purdue-fpga/hammerIO/README.md

### Deploy to GH Pages
```
sudo apt install mkdocs-material 
pip install ghp-import \ mkdocs-material-extensions \ pymdown-extensions
make
```

### Run locally in Docker
```
docker compose up
```
