purdue-fpga/hammerIO/docs/about.md

# About

This board was built as an SOET Capstone project by Team 27 during the 2024-2025 academic year.
