purdue-fpga/hammerIO/docs/info.md

# Known Issues and Recommendations

## Power Supply and Current Draw

The total current draw for the DE10-Lite board and the extension shield with all peripherals active at once is estimated at 491.3 mA. This value at peak usage approaches the limit of the voltage regulator's capacity of 500mA. While it is unlikely that users will operate all peripherals simultaneously, given the shield’s primary use in educational settings, users should still exercise caution when using additional expansions, like PMOD. Individual current draw values for each component are summarized below.

| Peripheral | Part Number | Current Draw while Active (mA) | Number of Components | Total Current Draw (mA) | Justification  |
|---|---|---|---|---|---|
| LEDs | 150141AS73100 | 20 | 8 | 160 | Datasheet |
| ADC | MAX11664 | 1.67 | 1 | 1.67 | Datasheet |
| DAC | AD7303 | 2.3 | 1 | 0.75 | Datasheet |
| Audio Codec (General) | SSM2603 | 19.6 | 1 | 19.6 | Datasheet |
| Audio Codec (Headphone Amplifier) | SSM2603 | 62.5 | 1 | 62.5 | Datasheet |
| Switch Pullup Resistors | N/A (10kΩ) | 0.33 | 8 | 2.64 | Ohm’s Law |
| LEDs (DE-10 Lite) | Unknown (330Ω current-limiting resistors) | 3.94 | 10 | 39.4 | Schematic |
| Switch Pullup Resistors (DE-10 Lite) | N/A (120kΩ) | 0.027 | 10 | 0.27 | Schematic |
| VGA Resistor Network (DE10-Lite) | N/A (Resistance varies) | 22.28 | 1 | 22.28 | Schematic |
| SDRAM (DE10-Lite) | IS42S16320D | 180 | 1 | 180 | Datasheet |
| Accelerometer (DE10-Lite) | ADXL345 | 0.14 | 1 | 0.14 | Datasheet |
| FPGA (DE10-Lite) | 10M50DAF484 | 0.60 | 1 | 0.60 | Datasheet |

## Clock Source Configuration

During testing, it was observed that using multiple clock sources to drive peripherals resulted in unexpected behavior in the Quartus software, including irregular placement of logic gates. To mitigate this issue, users should configure the FPGA to use a single clock source with appropriate clock dividers for different devices. This approach ensures stable and reliable operation of the shield.

## Signal Observation via Test Points

The board features multiple test points for signals, including the audio codec signals, I2C and SPI interfaces pins, and intermediate signals from PS/2, DAC and ADC. Users should exercise caution when probing these test points, as improper handling could lead to short circuit, noise interference or signal distortion.

## Jumper Configuration

Incorrect jumper settings for the ADC channels could result in unexpected input values. Users are encouraged to refer to the jumper configuration instructions and double-check their settings to ensure proper operation.

## Recommendations for Assembly

During installation, ensure that standoffs are securely tightened to avoid mechanical instability, which could damage the board or affect signal quality.

## Parts List

| Peripheral | Part # | Quantity |
|---|---|---|
| ADC | [MAX11664](https://www.digikey.com/en/products/detail/analog-devices-inc-maxim-integrated/MAX11664AUB-T/2776904) | 1 |
| DAC | [AD7303](https://www.digikey.com/en/products/detail/analog-devices-inc/AD7303BRMZ-REEL7/760443) | 1 |
| Audio Codec | [SSM2603](https://www.digikey.com/en/products/detail/analog-devices-inc/SSM2603CPZ-REEL7/1825572) | 1 |
| Voltage Regulator | [TLV1117LV33](https://www.digikey.com/en/products/detail/texas-instruments/TLV1117LV33DCYR/2666508) | 1 |
| PS/2 | [KMDTX-HT-6S-BSC](https://www.digikey.com/en/products/detail/kycon-inc/KMDTX-HT-6S-BSC/10246538) | 1 |
| SMA | [PCB.SMAFRA.HT](https://www.digikey.com/en/products/detail/taoglas-limited/PCB.SMAFRA.HT/5034736) | 5 |
| Audio Jack | [SJ-3524-SMT-TR](https://www.digikey.com/en/products/detail/same-sky-formerly-cui-devices/SJ-3524-SMT-TR-BE/2295987) | 3 |
| LED | [150141AS73100](https://www.digikey.com/en/products/detail/w%C3%BCrth-elektronik/150141AS73100/4489951) | 8 |
| SPDT Switch | [OS102011MS2QN1](https://www.digikey.com/en/products/detail/analog-devices-inc/SSM2603CPZ-REEL7/1825572) | 8 |
| Joystick | [Adafruit 2765](https://www.digikey.com/en/products/detail/adafruit-industries-llc/2765/6193582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) | 1 |
| 40 Pin Header | [474-PRT-16763](https://www.mouser.com/ProductDetail/SparkFun/PRT-16763?qs=W/MpXkg%252BdQ5xeCq/GKjnlQ%3D%3D&mgh=1&gQT=1) | 1 |
| Arduino Header | [uxcell 16mm-len](https://www.amazon.com/uxcell-Straight-Connector-Arduino-Prototype/dp/B07DK2FXZ9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) | 1 |
| Standoff | [93505A103](https://www.mcmaster.com/93505A103) | 4 |

All other components were purchased directly through the JLCPCB assembly service.
