purdue-fpga/hammerIO/extra-documentation/kicad-project/Peripheral Board V0.3.kicad_pcb

## KiCad design extra-documentation/kicad-project/Peripheral Board V0.3.kicad_pcb (2025-04-29)

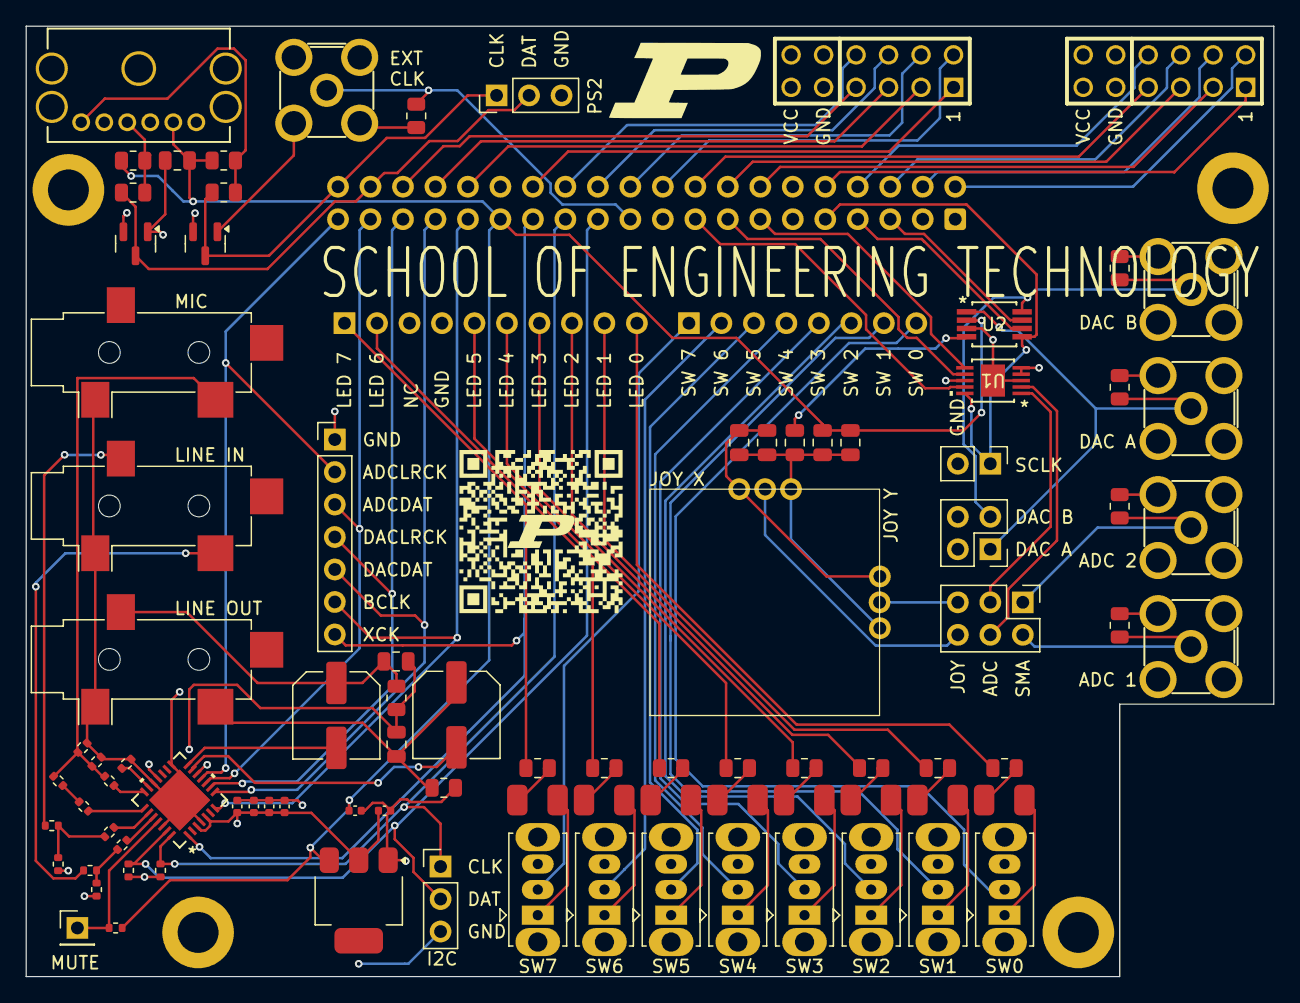
[picture p21: board Peripheral Board V0.3.kicad_pcb from above]

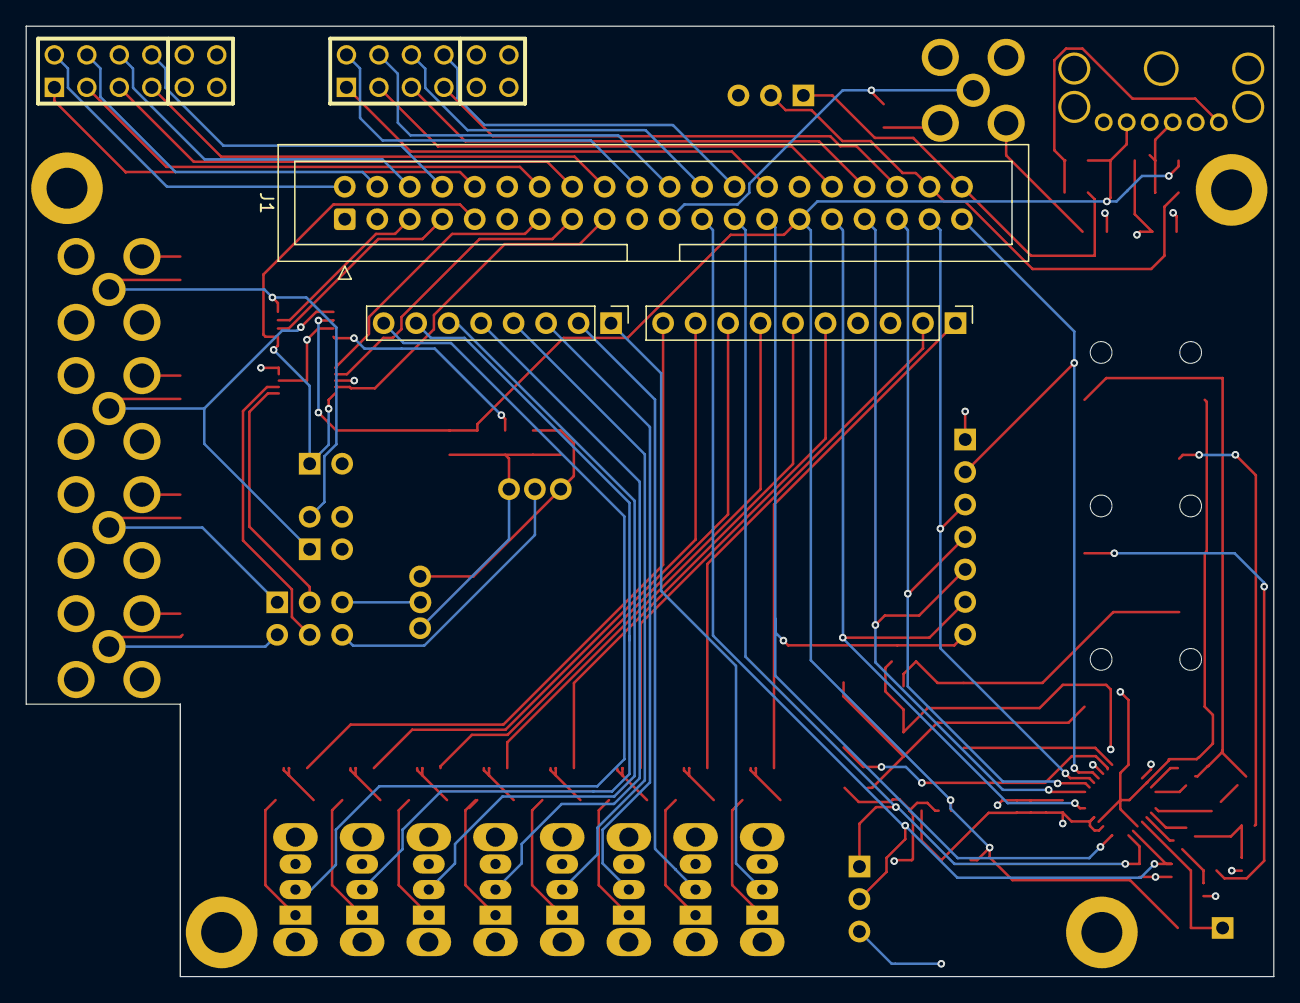
[picture p22: board Peripheral Board V0.3.kicad_pcb from below]

Board: 4 copper layers, 97.6 x 74.3 mm, 94 parts (3 on the bottom side), 88 nets.

Parts:
C1, C2, C3, C20: 0.1uF; C_0805_2012Metric
C4, C21: 10uF; C_0805_2012Metric
C5, C9, C10, C11: 0.1uF; C_0402_1005Metric
C6: 10uF; R_0402_1005Metric
C7, C8: 1uF; C_0402_1005Metric
C12, C13, C14: 1uF; R_0402_1005Metric
C15: 1000pF; R_0402_1005Metric
C16, C17: 220uF; C_Elec_6.3x7.7
C18, C19: 220pF; C_0805_2012Metric
D0, D1, D2, D3, D4, D5, D6, D7: LED; 150141AS73100-LED
D9, D10: BAT54S; SOT-23
J1: 2x20 GPIO header; IDC-Header_2x20_P2.54mm_Vertical
J2, J3: Conn_02x06_Counter_Clockwise; pmod
J4: Conn_02x02_Top_Bottom; PinHeader_2x02_P2.54mm_Vertical
J5: Mini-DIN-6; KMDTX-HT-6S-BSC_KYC
J6: Conn_02x03_Top_Bottom; PinHeader_2x03_P2.54mm_Vertical
J7: Conn_01x01; PinHeader_1x01_P2.54mm_Vertical
J8_1: Conn_01x10; PinHeader_1x10_P2.54mm_Vertical
J8_2: Conn_01x08; PinHeader_1x08_P2.54mm_Vertical
J9: EXT_CLK_IN; CONN_PCB.SMAFRA_TAL
J9-line-in1, J9-line-out1, J9-mic-in1: SJ-3524-SMT-BE; Jack_3.5mm_CUI_SJ-3524-SMT_Horizontal_fixed
J10: SCLK testpoint; PinHeader_1x02_P2.54mm_Vertical
J11: ADC_IN_1; CONN_PCB.SMAFRA_TAL
J12: ADC_IN_2; CONN_PCB.SMAFRA_TAL
J13: DAC_OUT_A; CONN_PCB.SMAFRA_TAL
J14: DAC_OUT_B; CONN_PCB.SMAFRA_TAL
J18: I2C_testpoint; PinHeader_1x03_P2.54mm_Vertical
J19: AUD_testpoint; PinHeader_1x07_P2.54mm_Vertical
J20: PS2_testpoint; PinHeader_1x03_P2.54mm_Vertical
R0, R1, R2, R3, R4, R5, R6, R7: 680; R_0805_2012Metric
R9, R10: 2k; R_0805_2012Metric
R11, R12: 120; R_0805_2012Metric
R13, R14, R15: 2k; R_0402_1005Metric
R16, R17, R18, R19: 4.7k; R_0402_1005Metric
R20: 330; R_0402_1005Metric
R21: 680; R_0402_1005Metric
R22: 47k; R_0402_1005Metric
R23, R24: 47k; R_0805_2012Metric
R25, R26, R27, R28, R29: 1k; R_0805_2012Metric
SW0, SW1, SW2, SW3, SW4, SW5, SW6, SW7: SW_SPDT; SW_Slide_SPDT_Straight_CK_OS102011MS2Q
U1: MAX11664 ADC; 21-0109D_MXM
U2: AD7303 DAC; RM_8_ADI
U3: SSM2603 audio codec; CP_28_4_ADI
U4: Adafruit2765
U5: TLV1117-33; SOT-223

Connections:
+3.3V: C20.2, C21.2, D9.2 (K), D10.2 (K), J1.11, J2.6, J2.12, J3.6, J3.12, SW0.3 (C), SW1.3 (C), SW2.3 (C), SW3.3 (C), SW4.3 (C), SW5.3 (C), SW6.3 (C), SW7.3 (C), U1.4 (REF), U1.5 (VDD), U1.8 (OVDD), U4.3 (Vref), U4.6 (Vref)
+3.3VA: C5.2, C7.2, C9.2, C10.2, C11.2, R14.2, R15.2, U3.3 (DCVDD), U3.5 (DBVDD), U3.12 (HPVDD), U3.18 (AVDD), U5.2 (VO)
+5V: C2.2, C3.2, C4.2, C8.2, J1.29, J5.5, R9.2, R10.2, R13.2, U2.2 (VDD), U5.3 (VI)
/ADC_CHSEL: J1.15, U1.7 (CHSEL)
/ADC_CS: J1.13, U1.6 (*CS)
/ADC_DOUT: J1.17, U1.9 (DOUT)
/ADC_IN_1: J6.2, J11.1, R29.2
/ADC_IN_2: J6.1, J12.1, R26.2
/AUD_ADCDAT: J1.37, J19.3, U3.10 (RECDAT)
/AUD_ADCLRCK: J1.39, J19.2, U3.11 (RECLRC)
/AUD_BCLK: J1.31, J19.6, U3.7 (BCLK)
/AUD_DACDAT: J1.33, J19.5, U3.8 (PBDAT)
/AUD_DACLRCK: J1.35, J19.4, U3.9 (PBLRC)
/AUD_XCK: J1.27, J19.7, U3.1 (MCLK/XTI)
/CLK: J5.6, R10.1, R11.1
/DAC_DIN: J1.7, U2.6 (DIN)
/DAC_OUT_A: J4.1, J13.1, R27.2, U2.1 (VOUTA)
/DAC_OUT_B: J4.3, J14.1, R28.2, U2.8 (VOUTB)
/DAC_SYNC: J1.5, U2.7 (SYNC*)
/Data: J5.1, R9.1, R12.1
/EXT_CLK: J1.21, J9.1, R25.2
/I2C_SCLK: J1.25, J18.1, R14.1, U3.28 (SCLK)
/I2C_SDAT: J1.23, J18.2, R15.1, U3.27 (SDIN)
/LED0: J8_1.1, R0.1
/LED1: J8_1.2, R1.1
/LED2: J8_1.5, R2.1
/LED3: J8_1.6, R3.1
/LED4: J8_1.7, R4.1
/LED5: J8_1.8, R5.1
/LED6: J8_1.9, R6.1
/LED7: J8_1.10, R7.1
/L_line_in: J9-line-in1.2 (T), R18.2
/L_line_out: C17.1, C18.1, J9-line-out1.2, R23.2
/PMOD_00_00: J1.20, J2.7
/PMOD_00_01: J1.22, J2.8
/PMOD_00_02: J1.24, J2.9
/PMOD_00_03: J1.26, J2.10
/PMOD_00_04: J1.28, J2.1
/PMOD_00_05: J1.32, J2.2
/PMOD_00_06: J1.34, J2.3
/PMOD_00_07: J1.36, J2.4
/PMOD_01_00: J1.2, J3.7
/PMOD_01_01: J1.4, J3.8
/PMOD_01_02: J1.6, J3.9
/PMOD_01_03: J1.8, J3.10
/PMOD_01_04: J1.10, J3.1
/PMOD_01_05: J1.14, J3.2
/PMOD_01_06: J1.16, J3.3
/PMOD_01_07: J1.18, J3.4
/PS2_CLK: D9.3 (COM), J1.40, J20.1, R11.2
/PS2_DAT: D10.3 (COM), J1.38, J20.2, R12.2
/R_line_in: J9-line-in1.3 (R), R19.2
/R_line_out: C16.1, C19.1, J9-line-out1.3, R24.2
/SCLK: J1.9, J10.1, U1.10 (SCLK), U2.5 (SCLK)
/SW0: J8_2.1, SW7.2 (B)
/SW1: J8_2.2, SW6.2 (B)
/SW2: J8_2.3, SW5.2 (B)
/SW3: J8_2.4, SW4.2 (B)
/SW4: J8_2.5, SW3.2 (B)
/SW5: J8_2.6, SW2.2 (B)
/SW6: J8_2.7, SW1.2 (B)
/SW7: J8_2.8, SW0.2 (B)
/mic_in: C14.1, C15.2, J9-mic-in1.2, R21.2, R22.2
GND: C1.1, C2.1, C3.1, C4.1, C5.1, C6.1, C7.1, C8.1, C9.1, C10.1, C11.1, C15.1, C18.2, C19.2, C20.1, C21.1, D0.1 (K), D1.1 (K), D2.1 (K), D3.1 (K), D4.1 (K), D5.1 (K), D6.1 (K), D7.1 (K), D9.1 (A), D10.1 (A), J1.12, J1.30, J2.5, J2.11, J3.5, J3.11, J4.2, J4.4, J5.3, J8_1.4, J9.2, J9.3, J9.4, J9.5, J9-line-in1.1 (S), J9-line-out1.1, J9-mic-in1.1, J10.2, J11.2, J11.3, J11.4, J11.5, J12.2, J12.3, J12.4, J12.5, J13.2, J13.3, J13.4, J13.5, J14.2, J14.3, J14.4, J14.5, J18.3, J19.1, J20.3, R16.1, R17.1, R22.1, R23.1, R24.1, R25.1, R26.1, R27.1, R28.1, R29.1, SW0.1 (A), SW1.1 (A), SW2.1 (A), SW3.1 (A), SW4.1 (A), SW5.1 (A), SW6.1 (A), SW7.1 (A), U1.3 (AGND), U1.11 (EPAD), U2.3 (GND), U3.4 (DGND), U3.15 (PGND), U3.19 (AGND), U3.26 (CSB), U3.29 (EP), U4.1 (gnd), U4.4 (gnd), U5.1 (GND)
unnamed: C12.1, R17.2, R18.1
unnamed: C13.1, R16.2, R19.1
unnamed: C14.2, R20.2
unnamed: D0.2 (A), R0.2
unnamed: D1.2 (A), R1.2
unnamed: D2.2 (A), R2.2
unnamed: D3.2 (A), R3.2
unnamed: D4.2 (A), R4.2
unnamed: D5.2 (A), R5.2
unnamed: D6.2 (A), R6.2
unnamed: D7.2 (A), R7.2
unnamed: J6.3, U1.1 (AIN1)
unnamed: J6.4, U1.2 (AIN2)
unnamed: J6.5, U4.2 (xRead)
unnamed: J6.6, U4.5 (yRead)
unnamed: J7.1, R13.1, U3.25 (MUTE)
unnamed: C1.2, U2.4 (REF)
unnamed: C17.2, U3.13 (LHPOUT)
unnamed: C12.2, U3.24 (LLINEIN)
unnamed: R21.1, U3.21 (MICBIAS)
unnamed: R20.1, U3.22 (MICIN)
unnamed: C16.2, U3.14 (RHPOUT)
unnamed: C13.2, U3.23 (RLINEIN)
unnamed: C6.2, U3.20 (VMID)
